drorcaspi/caspiquad/Hardware/Arduino AVCC filtering 1.JPG

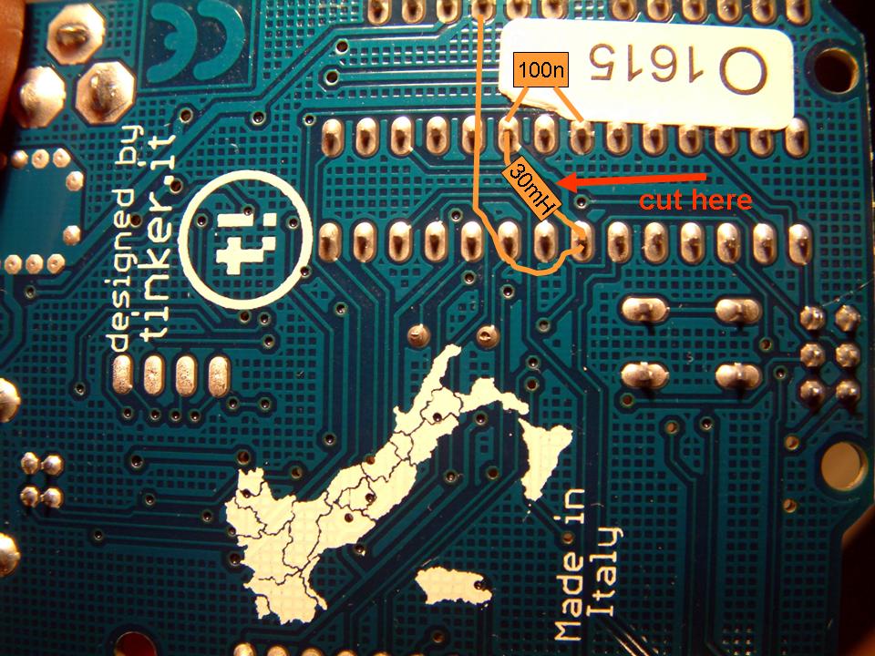
Hardware/Arduino AVCC filtering 1.JPG
