drorcaspi/caspiquad/Hardware/Arduino AVCC filtering 2.JPG

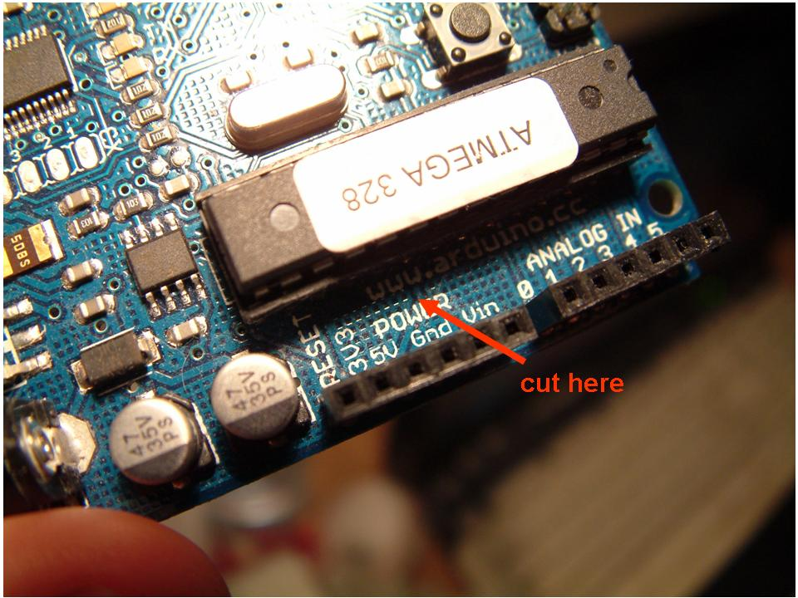
Hardware/Arduino AVCC filtering 2.JPG
