drorcaspi/caspiquad/Hardware/Led Strip Driver Schematic.pdf

# CaspiQuad 1 LED Strip Driver Board

# Dror Caspi, November 11, 2009

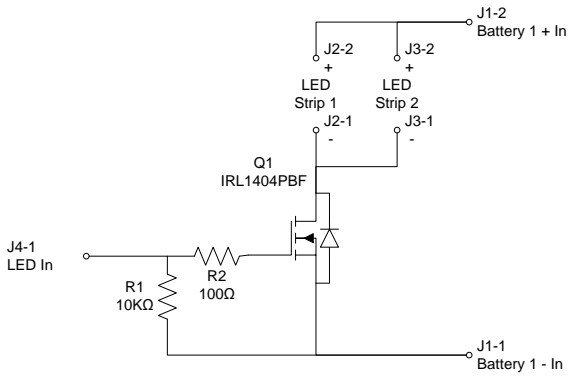
[picture p3: figure]
J4-1 LED In; LED Strip 1 Q1 IRL1404PBF; J1-1 Battery 1 - In; J1-2 Battery 1 + In; J3-2 + LED Strip 2
