drorcaspi/caspiquad/Docs/altitude measurement.xls

Sheet: גיליון3
Column1
Mean | 22.486
Standard Error | 0.2725438833
Median | 23
Mode | 29
Standard Deviation | 6.0942665
Sample Variance | 37.14008417
Kurtosis | -0.8884531663
Skewness | -0.1509197652
Range | 26
Minimum | 10
Maximum | 36
Sum | 11243
Count | 500

Sheet: גיליון4
Column1
Mean | -14.22
Standard Error | 0.464127168
Median | -14
Mode | -10
Standard Deviation | 10.37819898
Sample Variance | 107.707014
Kurtosis | -0.9349075592
Skewness | 0.08497031285
Range | 46
Minimum | -36
Maximum | 10
Sum | -7110
Count | 500

Sheet: גיליון1
0.01 | 18 | -12 | 32
0.02 | 18 | -12
0.03 | 18 | -10
0.04 | 18 | -8
0.05 | 18 | -6
0.06 | 18 | -4
0.07 | 17 | -5
0.08 | 17 | -6
0.09 | 16 | -7
0.10 | 15 | -8
0.11 | 15 | -12
0.12 | 14 | -16
0.13 | 13 | -20
0.14 | 12 | -24
0.15 | 13 | -26
0.16 | 13 | -27
0.17 | 14 | -29
0.18 | 13 | -30
0.19 | 12 | -30
0.20 | 11 | -30
0.21 | 11 | -30
0.22 | 11 | -30
0.23 | 11 | -30
0.24 | 12 | -30
0.25 | 12 | -30
0.26 | 12 | -30
0.27 | 12 | -32
0.28 | 13 | -33
0.29 | 13 | -35
0.30 | 12 | -36
0.31 | 11 | -35
0.32 | 11 | -35
0.33 | 11 | -34
0.34 | 11 | -34
0.35 | 11 | -32
0.36 | 11 | -31
0.37 | 10 | -29
0.38 | 10 | -28
0.39 | 11 | -28
0.40 | 11 | -28
0.41 | 12 | -28
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
