drorcaspi/caspiquad/Hardware/CaspiQuad1 shield schematic.pdf

# Arduino Proto Shield

# CaspiQuad 1

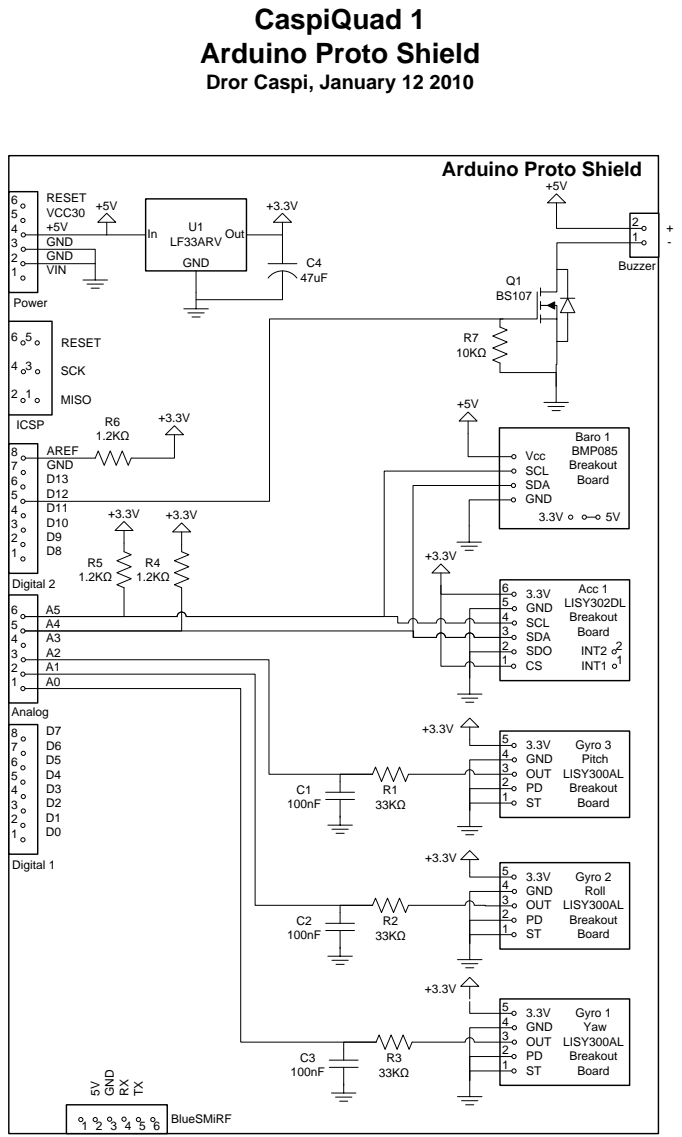
[picture p4: page 1]

Baro 1 BMP085 Breakout Board Vcc
