drorcaspi/caspiquad/Hardware/CaspiQuad1 interconnect schematic.pdf

## Bat Sensor / Interconnect

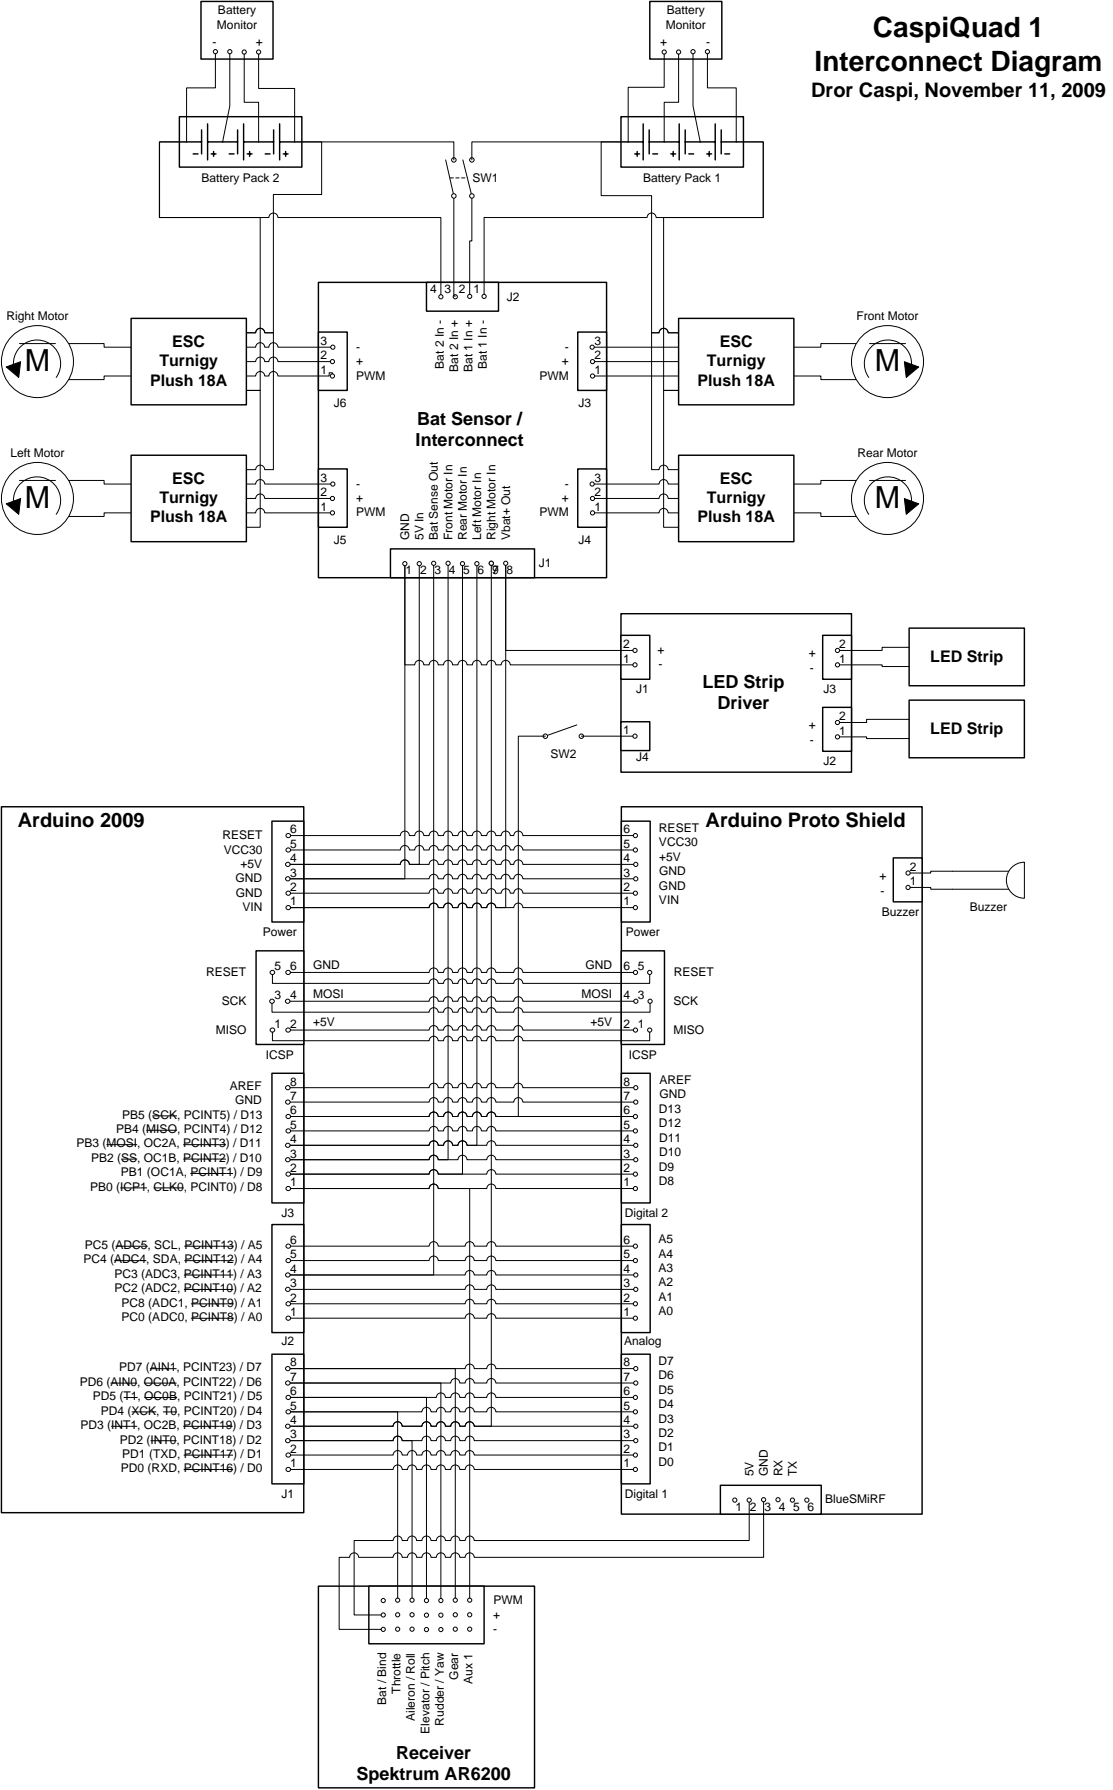
[picture p5: page 1]

Bat 1 In - Bat 1 In + Bat 2 In + Bat 2 In - 8

Aux 1 Gear Rudder / Yaw Elevator / Pitch Aileron / Roll Throttle Bat / Bind
