drorcaspi/caspiquad/Hardware/Battery Sensor and Interconnect Board Schematic.pdf

# CaspiQuad 1 Dual Battery Minimum Voltage Sensor / Interconnect Board

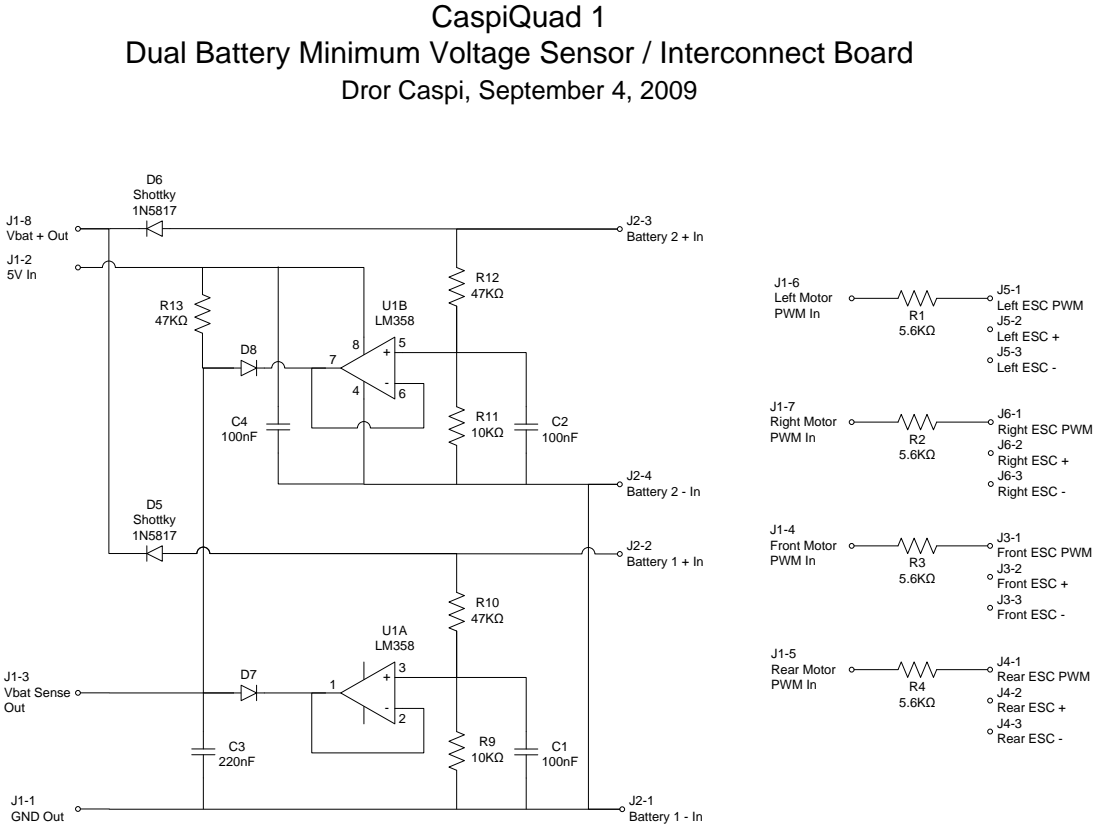
[picture p6: page 1]

J5-1 Left ESC PWM J1-6 Left Motor PWM In
J5-2 Left ESC + J5-3 Left ESC - J6-1 Right ESC PWM J6-2 Right ESC + J6-3 Right ESC - J3-1 Front ESC PWM J3-2 Front ESC + J3-3 Front ESC - J4-1 Rear ESC PWM J4-2 Rear ESC + J4-3 Rear ESC -

J1-7 Right Motor PWM In

J1-4 Front Motor PWM In J2-4 Battery 2 - In

J1-5 Rear Motor PWM In J2-2 Battery 1 + In D5 Shottky 1N5817

J2-1 Battery 1 - In J1-1 GND Out
