drorcaspi/caspiquad/Hardware/Quad Brushed Motor Controller Schematic.pdf

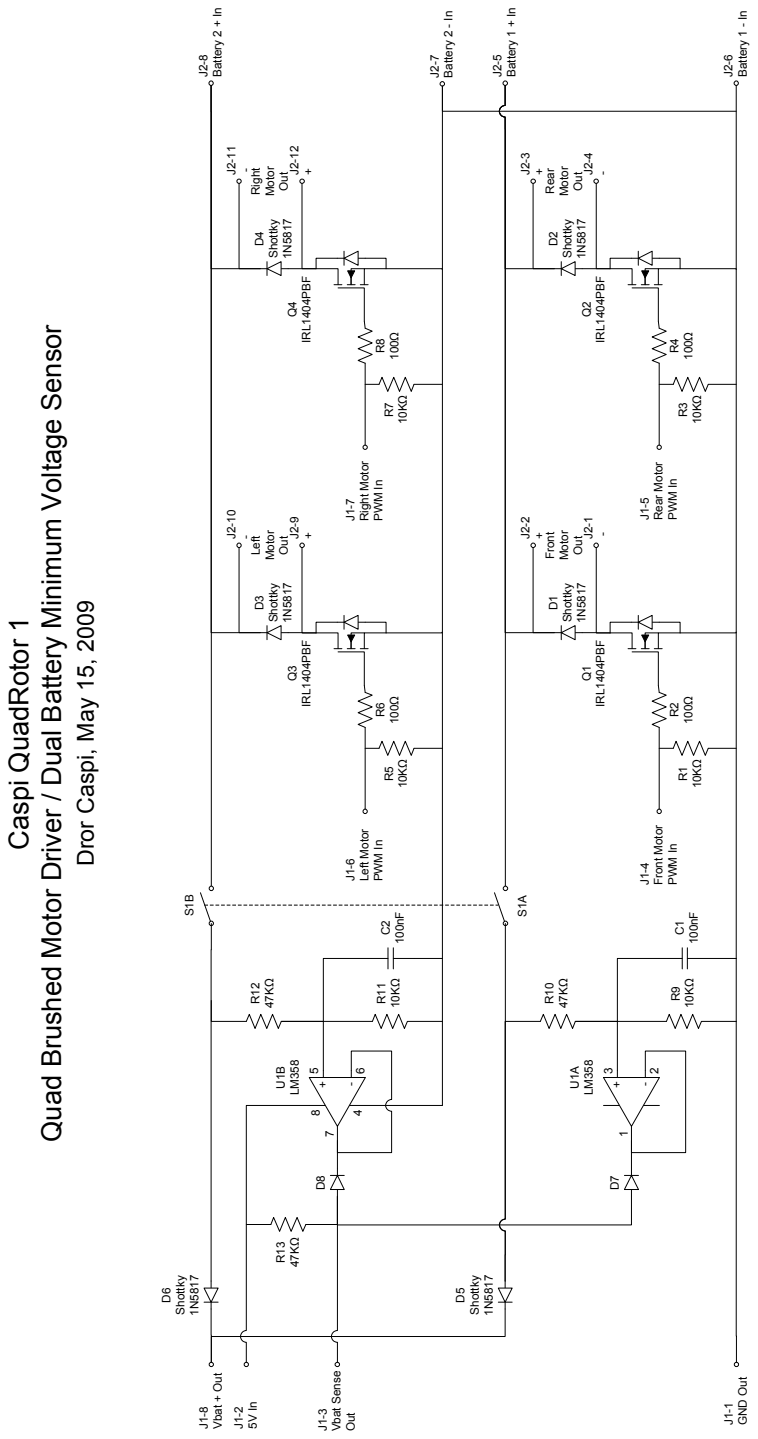
[picture p7: page 1]

Quad Brushed Motor Driver / Dual Battery Minimum Voltage Sensor
