drorcaspi/caspiquad/Hardware/Old/CaspiQuad1 interconnect schematic.pdf

# 1 Bat 2 In + 8

# CaspiQuad 1

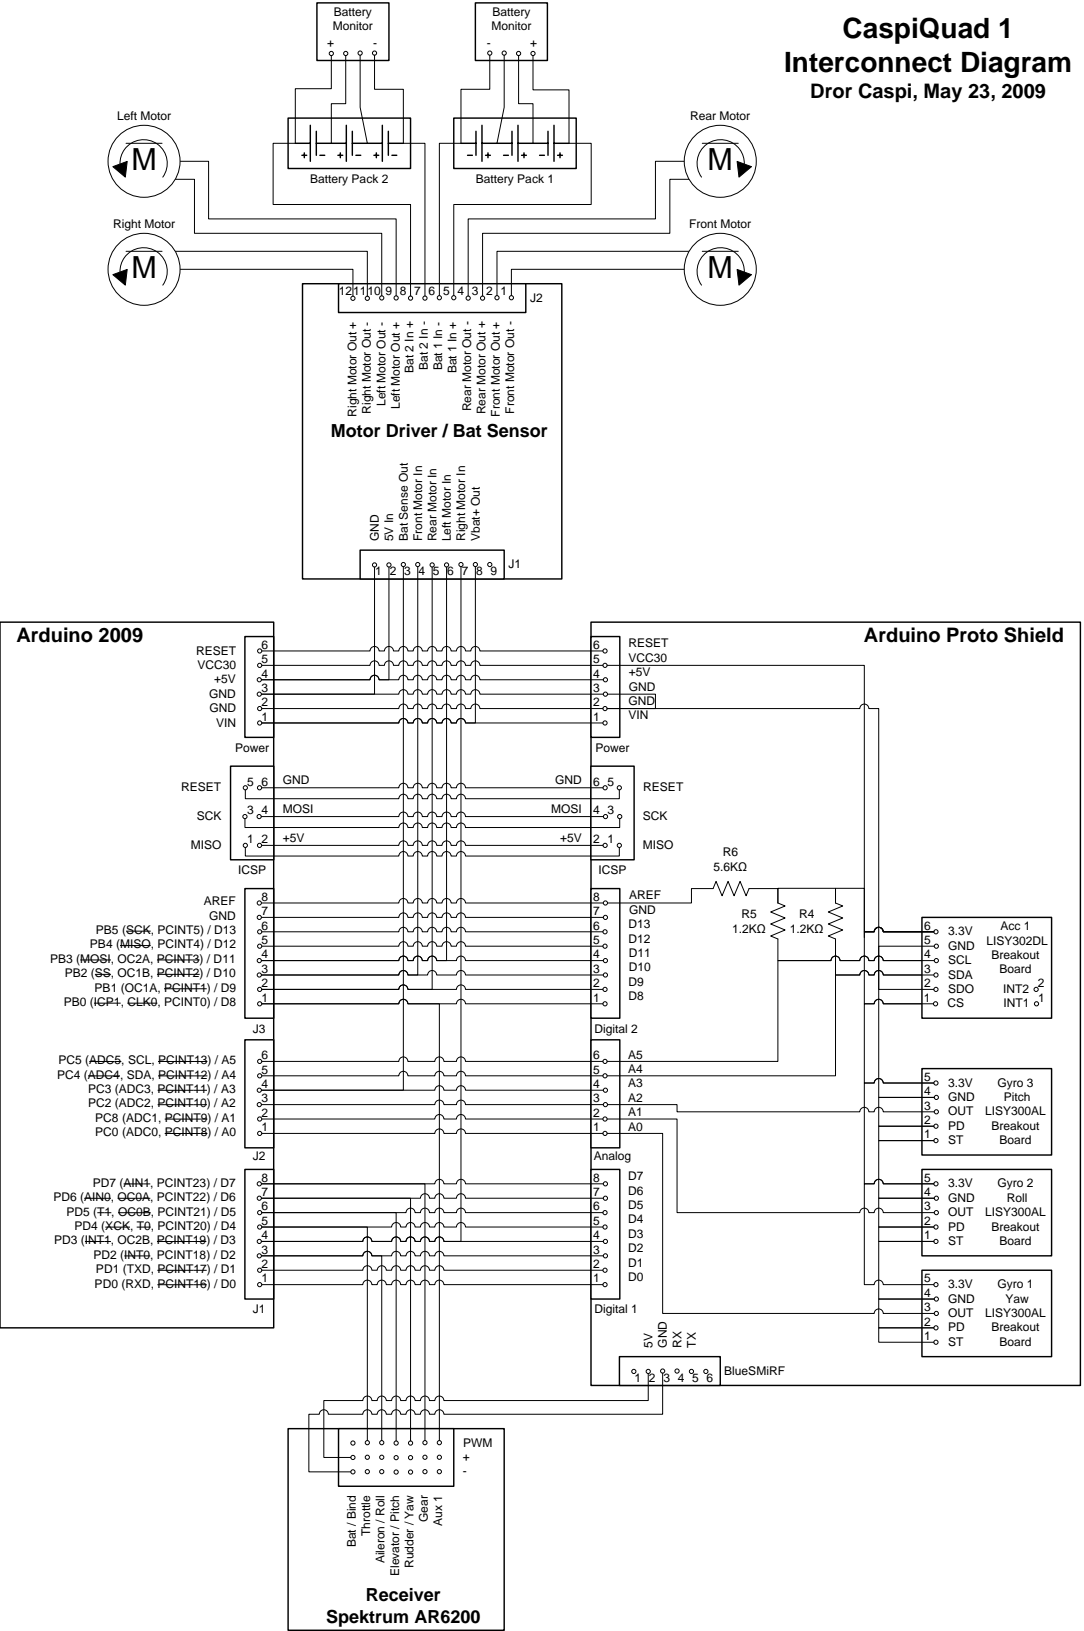
[picture p8: page 1]

Left Motor Out + Left Motor Out - Right Motor Out - Right Motor Out + Battery Monitor + - Battery Monitor - +

Motor Driver / Bat Sensor

Aux 1 Gear Rudder / Yaw Elevator / Pitch Aileron / Roll Throttle Bat / Bind
