drorcaspi/caspiquad/CaspiQuad/axis_translation.h

#ifndef __AXIS_TRANSLATION_H__
#define __AXIS_TRANSLATION_H__

//=============================================================================
//
// Tables for axes translation between aircraft axes and earth axes
//
//=============================================================================

/*-----------------------------------------------------------------------------
  CaspiQuad 1
  Copyright (c) 2009 Dror Caspi.  All rights reserved.

  Based on AeroQuad (http://www.AeroQuad.info)
  Copyright (c) 2009 Ted Carancho.  All rights reserved.
 
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
  You should have received a copy of the GNU General Public License 
  along with this program. If not, see <http://www.gnu.org/licenses/>. 
-----------------------------------------------------------------------------*/

//=============================================================================
//
// The data below is taken from the Excel file axis_translation.xls
//
//=============================================================================

// Size of the two-dimensional tables

#define COEFF_TABLE_SPAN          32

// Number of bits to shift the rotation angle (represented as 15-bit unsigned) to
// get coefficient table row or column number (5 bits)

#define COEFF_TABLE_ANGLE_SHIFT    8

// Maximum angle that has a representation in the table

#define COEFF_TABLE_MAX_ANGLE   ((COEFF_TABLE_SPAN - 1) << COEFF_TABLE_ANGLE_SHIFT)

// Representaion of 1.0 in the tables

#define COEFF_TABLE_FACTOR_SHIFT   8
#define COEFF_TABLE_FACTOR       256

// Measured Z acceleration coefficient table, stored in program memory (since it is constant and too large
// for the AVR's tiny RAM

static const uint8_t z_acc_z_coeff_table[COEFF_TABLE_SPAN][COEFF_TABLE_SPAN] PROGMEM =
{
  {128, 128, 128, 128, 127, 127, 127, 126, 126, 125, 124, 123, 122, 122, 121, 119, 118, 117, 116, 114, 113, 111, 110, 108, 106, 105, 103, 101, 99,  97,  95,  93},
  {128, 128, 128, 128, 127, 127, 127, 126, 126, 125, 124, 123, 122, 122, 120, 119, 118, 117, 116, 114, 113, 111, 110, 108, 106, 105, 103, 101, 99,  97,  95,  93},
  {128, 128, 128, 127, 127, 127, 126, 126, 125, 125, 124, 123, 122, 121, 120, 119, 118, 117, 116, 114, 113, 111, 110, 108, 106, 105, 103, 101, 99,  97,  95,  93},
  {128, 128, 127, 127, 127, 127, 126, 126, 125, 125, 124, 123, 122, 121, 120, 119, 118, 117, 115, 114, 113, 111, 109, 108, 106, 104, 103, 101, 99,  97,  95,  92},
  {127, 127, 127, 127, 127, 126, 126, 126, 125, 124, 124, 123, 122, 121, 120, 119, 118, 116, 115, 114, 112, 111, 109, 108, 106, 104, 102, 100, 98,  96,  94,  92},
  {127, 127, 127, 127, 126, 126, 126, 125, 125, 124, 123, 122, 122, 121, 120, 119, 117, 116, 115, 113, 112, 111, 109, 107, 106, 104, 102, 100, 98,  96,  94,  92},
  {127, 127, 126, 126, 126, 126, 125, 125, 124, 124, 123, 122, 121, 120, 119, 118, 117, 116, 114, 113, 112, 110, 109, 107, 105, 104, 102, 100, 98,  96,  94,  92},
  {126, 126, 126, 126, 126, 125, 125, 124, 124, 123, 122, 122, 121, 120, 119, 118, 117, 115, 114, 113, 111, 110, 108, 107, 105, 103, 101, 99,  98,  96,  94,  91},
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
  {0, 5, 9, 14, 19, 23, 28, 32, 37, 42, 46, 51, 55, 60, 64, 69, 73, 77, 82, 86, 90, 95, 99, 103, 107, 111, 115, 119, 123, 127, 131, 135},
  {0, 5, 9, 14, 18, 23, 27, 32, 36, 41, 45, 50, 54, 58, 63, 67, 71, 76, 80, 84, 88, 93, 97, 101, 105, 109, 113, 117, 121, 125, 129, 133}
};

#endif
