drorcaspi/caspiquad/(commit log)

2009-06-22 Added EEPROM storage of 3 additional flight control parameters (flight control still not modular enough). Fixed some brushless motor control definitions
    [CaspiQuad.pde, eeprom_utils.h, motors.h]
2009-06-26 Updated for brushless motors
2009-06-27 First version that works! Stabilizes on the test fixture. PID Values: - Roll Rate P = 11 D = 30 - Roll P = 20 D = 0
    [CaspiQuad.pde, MotorTest.pde, motors.h, quad.h, quad_hw.h]
2009-08-15 Add auto-center of receiver rotation input, auto-scaling of throttle min/max, setup sub-states etc. DOES NOT COMPILE YET
2009-08-17 Modified the indicator module to support both LED and buzzer
    [CaspiQuad.pde, indicators.h]
2009-08-21 - Added scaling of motor inputs to reduce rounding errors - Added battery sensor This version compiles but has not been debugged
    [CaspiQuad.pde, bat_sensor.h, bat_sensor.pde, indicators.h, motors.h, quad.h, receiver.pde]
2009-08-24 Still debugging throttle stable sensing...
2009-08-25 - Setup sequence debugged - Some more fixes - Seems to behave 'nice' with the Configurator
    Next step is to connect batteries, tune the parameters and debug
    [CaspiQuad.pde, motors.h, quad.h, receiver.h, receiver.pde]
2009-08-31 Fixed the motor commands calculation: the pitch sign was inverted
    [motors.h]
2009-08-31 Added thresholds and special treatment for no bat and single bat case
2009-08-31 battery sensor readings calibration
    [BatteryReadings.xlsx]
2009-08-31 Moved the battery readings spreadsheet to the new docs folder
    [BatteryReadings.xlsx]
2009-09-09 ADC test
2009-09-11 First flying version - Bat sensor disabled (needs calibration) - Main loop timing still based on millis(), as the adc_cycles-based timing has some bug
    [CaspiQuad.pde, bat_sensor.pde]
2009-09-12 Remove the smoothing of gyro readings, this is now done in the ADC module
2009-09-18 Fixed the motor throttle range so that it leaves guard bands at both extremes to allow rotation control
    [gyro.pde, motors.h, receiver.pde]
2009-09-19 Non-linear throttle response Compiled, not tested
2009-09-19 Added an option to get the filtered ADC without shifting back to original scale. Used that for gyro reading.
2009-09-19 Updated the battery readings
2009-09-19 updated readings after h/w mods
    [BatteryReadings.xlsx]
2009-09-21 replaced #defines with enums
    [quad.h]
2009-09-21 Added a 1 sec delay before starting the loop in order to let analog circuits and digital filters stabilize
    [CaspiQuad.pde]
2009-10-02 Converted the rotation measurement based on accelerometers to integer calculation, using a table prepared with an Excel file. Partially converted the rotation estimator to integer calculations.
    [atan.xls]
2009-10-05 Modified the yaw rotation estimation algorithm to use a simple integration of the gyro input, reset to 0 only when the stick returns to near-center from non-near-center. To facilitate this, created R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
    Compiled, not tested.
    [CaspiQuad.pde, rotation_estimator.h, rotation_estimator.pde]
2009-10-06 Modified the rotation receiver input interpretation: for roll & pitch, in the center region the receiver control rotation angle.
2009-10-07 - Added hardware_serial2 for interrupt-based serial transmission. - Renamed most of the .pde file to .cpp and fixed various #include problems
    [CaspiQuad.pde, PID.cpp, accel.cpp, adc.cpp, bat_sensor.cpp, eeprom_utils.cpp, gyro.cpp, hardware_serial2.cpp]
2009-11-11 Updated h/w schematics
2009-11-21 - Added code for earth-axis acceleration estimation. Does not work yet! - Added code to constrain motor rotation command before converting from float to int16_t
    [CaspiQuad.pde, axis_translation.h, quad.h]
2009-11-23 Improved indicators (complied, not tested): - Temp indication does not restart a temp indication of the same type - Non-temp indication does not restart an indication of the same type and a temp indi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
2009-11-23 Compiled TODO: flight_control.h is the public h file of flight control. Currently it exposes many public variables, should replace with accessor functions.
    [CaspiQuad.pde, flight_control.h, serial_telemetry.cpp]
2009-11-25 Fixed the indicators, added debug prints
    [CaspiQuad.pde, accel.cpp, indicators.cpp, indicators.h, quad.h, serial_telemetry.cpp]
2009-12-05 In an effort to solve the uncontrolled wobbling at low throttle, added mechanisms to better ensure proper limiting of rotation commands to the motors:
    1. Limit each rotation command:
    - Current available throttle modification range is
    calculated per the current throttle setting
    - Roll and pitch are limited to 75% of that range
    - Yaw is limited to 37.5% of the range
    2. Limit total motor commands in a symmetric way:
    - If the motor command on each of the motors exceeds
    its limits, then we scale down by 50% and try again.
    [motors.cpp]
2009-12-05 Updated the yaw estimator to do a high-pass on the yaw rate if the user is actively controlling yaw. This should eliminate the case where the I part of the yaw overcomes the user command and creates 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
2009-12-08 fixed hardware_serial, had to increase the rx buffer, still need cleanup
    [hardware_serial2.cpp, hardware_serial2.h, serial_telemetry.cpp]
2009-12-24 - Removed the auto-zeroing of roll & pitch receiver command. Instead, added support for manual calibration. This allows the transceiver trims to be used to balance the quad and make up for accelerome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
    Compiles, but not tested!
2009-12-25 Moved the zeroing of stick flutter around 0 to the main control loop, where it only affects yaw. This is done since we no longer center the pitch & roll
    [CaspiQuad.pde, flight_control.h, receiver.cpp, rotation_estimator.cpp, rotation_estimator.h]
2009-12-25 Flies very stable Manual pitch & roll centering indication mode does not work yet Earth-axis Z acceleration estimation does not work yet
    [CaspiQuad.pde, axis_translation.h, quad.h]
2010-01-05 Backup commit, not done Added pressure sensor reading
2010-01-06 Added the pressure sensor handler update to the main loop Debugged a dry-run calculation with the BMP085 data sheet example data
2010-01-08 Added I2C utilities Debugging pressure sensor (not done yet)
2010-01-10 Fixed the barometer module. It now reads air pressure and calculate altitude delta. Still need to integrate in the flight control
    [CaspiQuad.pde, accel.cpp, i2c.cpp, indicators.cpp, indicators.h, pressure.cpp, pressure.h]
2010-01-12 Added a test mode where the user can disable accelerometer readings using the AUX1 channel. Also added a display of accelerometer readings status.
    Compiled - not tested
2010-01-12 Updated with barometric sensor
2010-01-15 1st flight trial of altitude hold + switch to disable accels
2010-01-16 Added a safety checking of I2C polled read: abort after some number of tries. Return a status code which is propagated up to the main control loop and controls usage of accelerometer and barometer, s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
2010-01-16 Altitude hold incl. accelerometer input. First version, not yet very stable, currently ended in a crash :(
    [CaspiQuad.pde, accel.cpp, accel.h, baro.cpp, quad.h]
2010-01-16 Coordinate translation
    [earth_coordinates_xlat.xls]
2010-02-06 - Updates to the flight control to do a derivative of pitch/roll stick input - Put some order to the feature compilation switches and usage of receiver channels. ** The above has been tested and flie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
2010-10-02 *** NON_WORKING VERSION, BACKUP ONLY ***
    [atan.xls]
2010-10-22 Finally flying STABLE again!!!
    Added support of acrobatic mode and revived the mode where the stick controls rotation rate (not angle). Both can be controlled by a receiver channel and are available as compilation flags.
    In stable mode, when in rate-control, we got very stable flight with no wobble. Used the following parameters for pitch/roll:
    P: 30
    I: 2
    D: 0
    [CaspiQuad.pde, quad.h]
2010-10-29 Zeroing of pitch/roll is now controller by a receiver channel; eventually they will NOT be zeroed to allow trimming at the transmitter to correct accelerometer mis-positioning.
    [CaspiQuad.pde, quad.h]
2010-11-01 Further refinement of altitude hold. Initial tuning of PID to (1,0,0). Did not fly yet.
2010-11-02 Found that temperature measurement by the barometer is noisy. For our purpose, it is enough to measure temperature once on initialization.
    [altitude measurement.xls]
